NikoBrzezinski/stylophone/images/VolMin.jpg

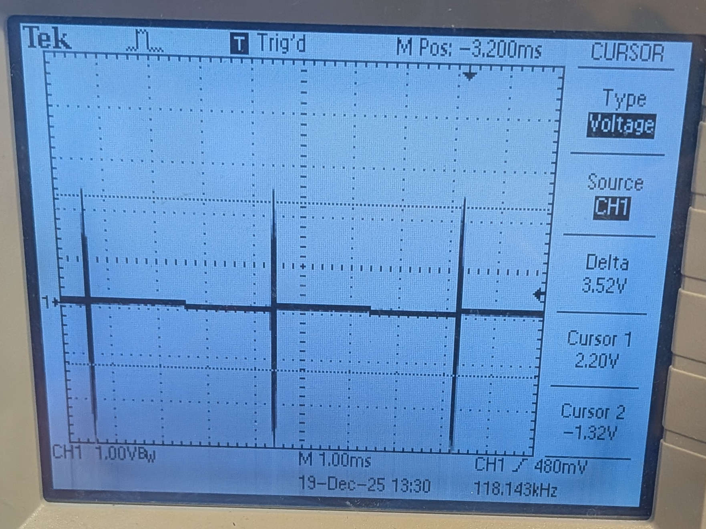
images/VolMin.jpg
