NikoBrzezinski/stylophone/images/PXL_20251219_131048569.jpg

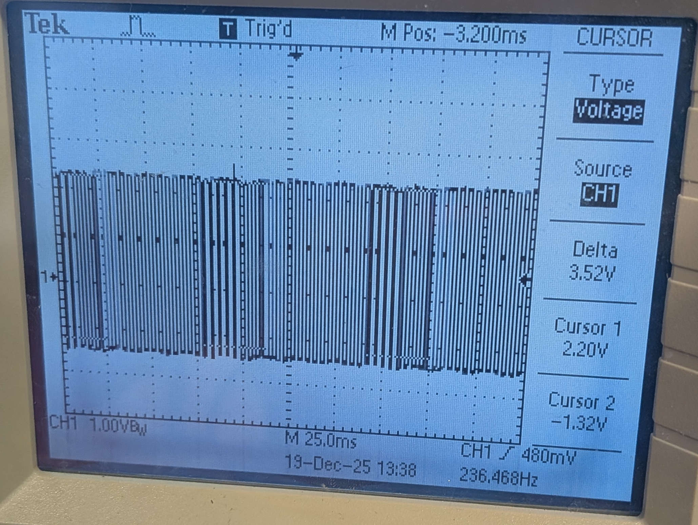
images/PXL_20251219_131048569.jpg
