NikoBrzezinski/stylophone/sprawko/main.tex

\documentclass{article}
\usepackage{graphicx} % Required for inserting images
\usepackage [utf8]{inputenc}
\usepackage {polski} 
\usepackage{float}

\title{Stylofon z efektem Vibrato}
\author{Brzeziński Radosław 277950}
\begin{document}
\maketitle
\tableofcontents
\section{Wstęp}
Projekt obejmuje zaprojektowanie, pomiary oraz wykonanie stylofonu z efektem vibrato, zbudowanego na bazie dwóch układów NE555. Częstotliwość dźwięku generowanego przez układ określana jest za pomocą stylusa. Im większa wartość rezystora, przez który układ zostaje w ten sposób zamknięty, tym niższa częstotliwość dźwięku.\newline
Pomysł na działanie układu zaczerpnięto z wcześniejszego zainteresowania projektowaniem syntezatorów oraz efektów dźwiękowych. \newline
Podstawowym źródłem wiedzy na temat budowy i działania układu były wcześniejsze wykłady oraz laboratoria, głównie zajęcia „Narzędzia CAD w projektowaniu układów elektronicznych”.

\section{Schemat układu i sposób działania}
\subsection{Działanie multiwibratora astabilnego}
\begin{figure}[H]
    \centering
    
    \caption{Licznik 555}
\end{figure}
\begin{figure}[H]
    \centering
    
    \caption{Multiwibrator astabilny}
\end{figure}
Działanie multiwibratora astabilnego składa się na dwie fazy.
\subsubsection{Faza ładowania kondensatora}
\begin{itemize}
    \item Po włączeniu zasilania kondensator C zaczyna się ładować przez $R_1+R_2$
    \item Napięcie na kondensatorze Vc rośnie wykładniczo
    \item Gdy Vc osiągnie poziom 2/3 Vcc, komparator 2 (TRESHOLD) ustawia przerzutnik RS a wyjście przechodzi w stan niski
    \item Tranzystor rozładowujący zostaje włączony i zaczyna rozładowywać kondensator przez $R_2$
\end{itemize}
\subsubsection{Faza rozładowania kondensatora}
\begin{itemize}
    \item Kondensator rozładowuje się przez $R_2$ do momentu, aż napięcie spadnie poniżej 1/3 Vcc.
    \item Komparator 1 (TRIGGER) resetuje przerzutnik RS a wyjście przechodzi w stan wysoki
    \item Tranzystor rozładowujący zostaje wyłączony i cykl rozpoczyna się od nowa
\end{itemize}
\subsection{Działanie stylofonu}
\begin{figure}[H]
    \centering
    
    \caption{Schemat ideowy stylofonu}
\end{figure}
\begin{figure}[H]
    \centering
    
    \caption{Schemat stylofonu}
\end{figure}
Stylofon składa się z dwóch układów NE555 pracujących w trybie multiwibratora astabilnego. Rezystor R2 układu generatora dźwięku został zastąpiony zestawem rezystorów oraz stylusem, który umożliwia wybór częstotliwości generowanego dźwięku. Wejście Control Voltage, kontrolujące napięcie graniczne, podłączone jest przez filtr dolnoprzepustowy do kolejnego układu NE555, również pracującego jako multiwibrator astabilny, co daje efekt vibrato. Filtr jest niezbędny do odfiltrowania wyższych harmonicznych z przebiegu prostokątnego generowanego przez układ. Wyjście generatora dźwięku podłączone jest do wzmacniacza operacyjnego w układzie voltage follower, co pozwala na podłączenie głośników o wyższej impedancji.\newline
\section{Symulacja oraz pomiary}
Analizie podano następujące parametry
\begin{itemize}
    \item Wyjście układu dźwięku oraz układu vibrato
    \item Przebieg wyjścia licznika 555 Tone
    \item Przebiegi ładowania i rozładowywania kondensatorów obu multiwibratorów
    \item Natężenie prądu pobieranego przez układ
    \item Wpływ potencjometru $R_{Volume}$
\end{itemize}
Analiza przeprowadzona jest dla napięcia Vcc = 5V, ponieważ układ przystosowany jest do zasilania przez port USB
\begin{figure}[H]
    \centering
    
    \caption{Przebiegi wyjść, dźwięku oraz vibrato}
\end{figure}
\begin{figure}[H]
    \centering
    
    \caption{Przebiegi ładowania i rozładowania kondensatorów}
\end{figure}
\begin{figure}[H]
    \centering
    
    \caption{Przebieg natężenia prądu źródła}
\end{figure}
\begin{figure}[H]
    \centering
    
    \caption{Schemat pomiarowy układu}
\end{figure}
\begin{figure}[H]
    \centering
    
    \caption{Wpływ potencjometry Volume}
\end{figure}
\section{Projekt płytki drukowanej}
\begin{figure}[H]
    \centering
    
    \caption{Projekt płytki PCB}
\end{figure}
\end{document}
