NikoBrzezinski/stylophone/images/Board.png

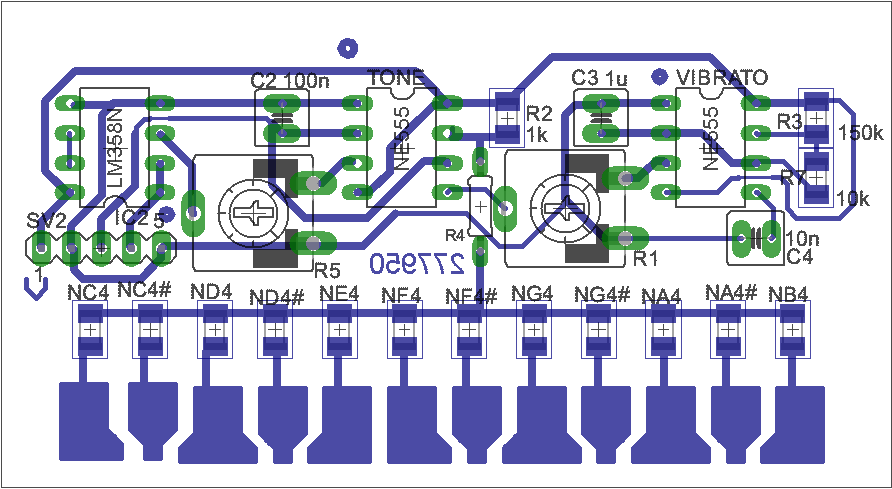
images/Board.png
