NikoBrzezinski/stylophone/images/C4.jpg

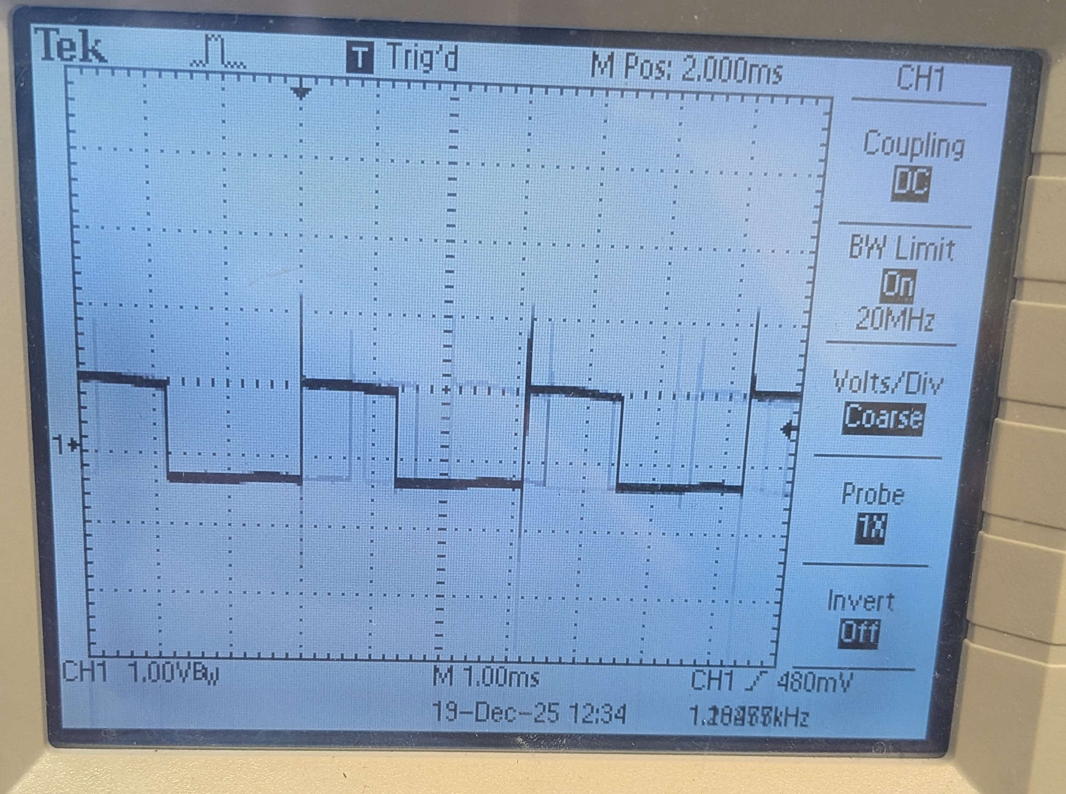
images/C4.jpg
