NikoBrzezinski/stylophone/images/CapTone.jpg

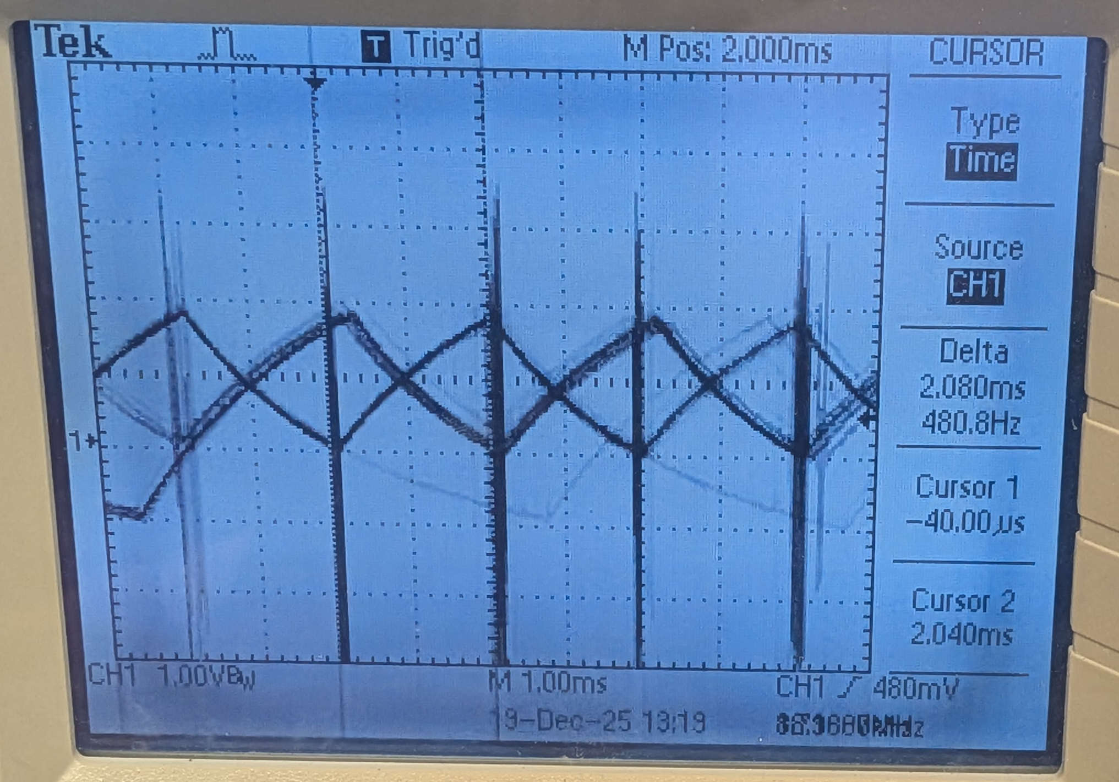
images/CapTone.jpg
