NikoBrzezinski/stylophone/images/CapVib.jpg

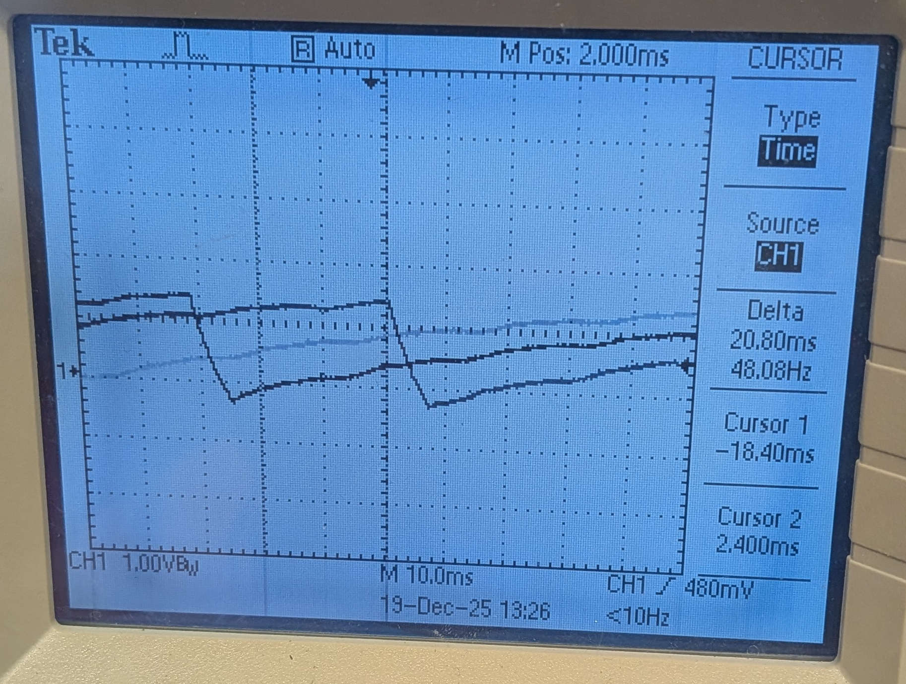
images/CapVib.jpg
