NikoBrzezinski/stylophone/images/OutTonePotMax.jpg

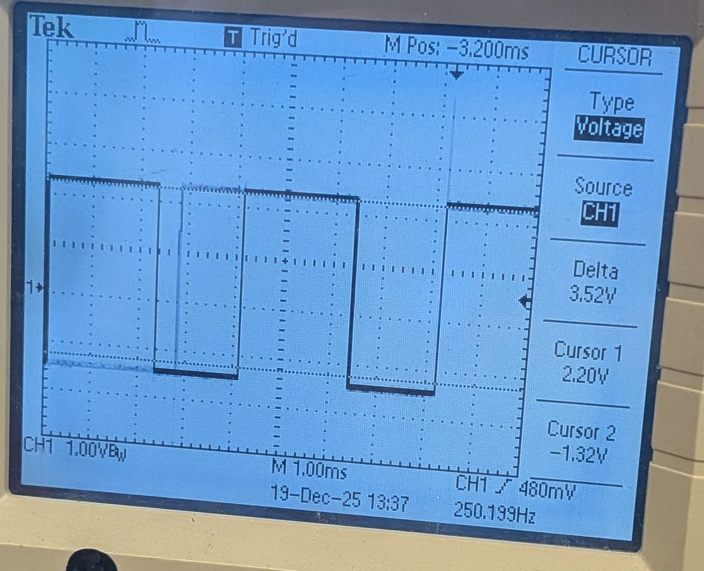
images/OutTonePotMax.jpg
