NikoBrzezinski/stylophone/images/OutTonePotMin.jpg

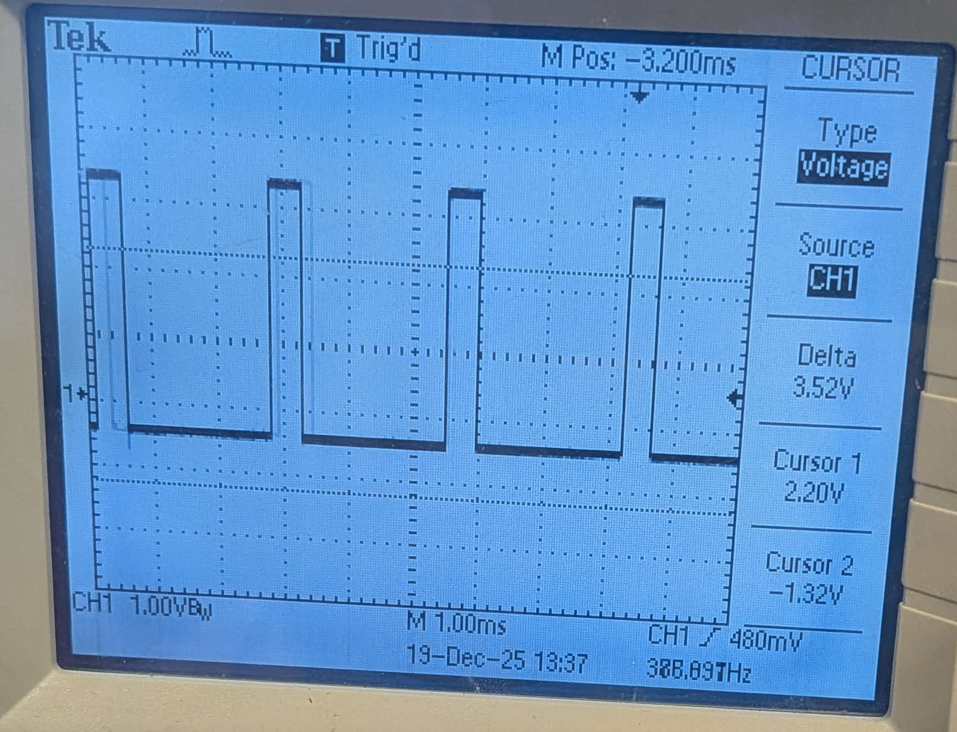
images/OutTonePotMin.jpg
