NikoBrzezinski/stylophone/images/OutVibPotMax.jpg

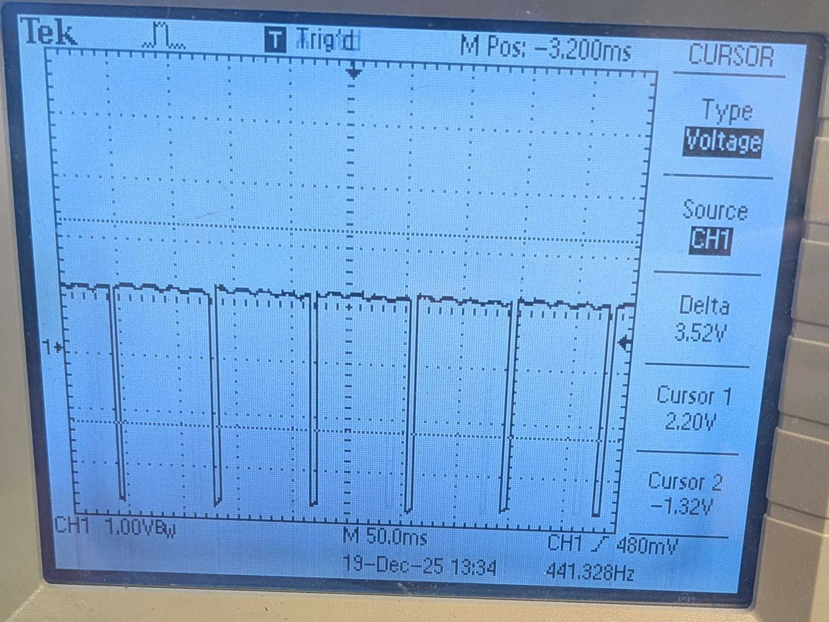
images/OutVibPotMax.jpg
