NikoBrzezinski/stylophone/images/OutVibPotMin.jpg

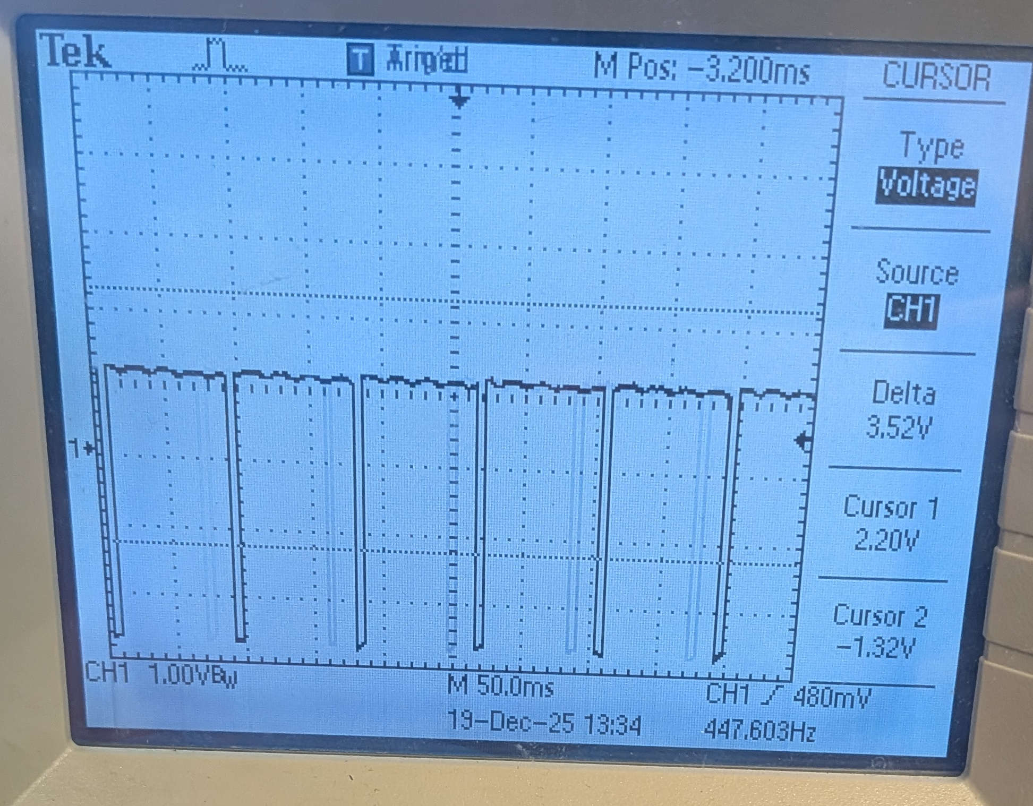
images/OutVibPotMin.jpg
