NikoBrzezinski/stylophone/images/PXL_20251219_131112526.jpg

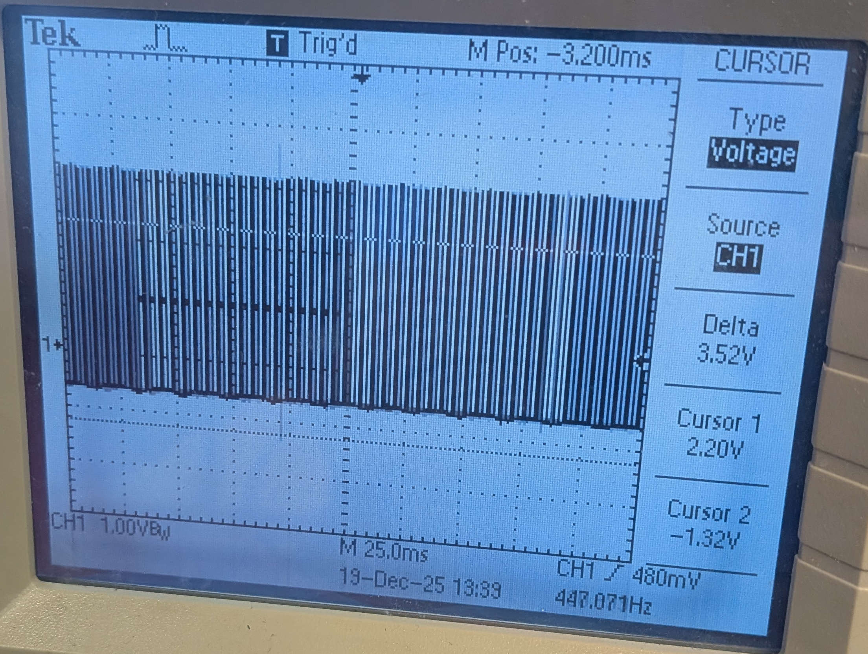
images/PXL_20251219_131112526.jpg
