NikoBrzezinski/stylophone/images/schematEagle.png

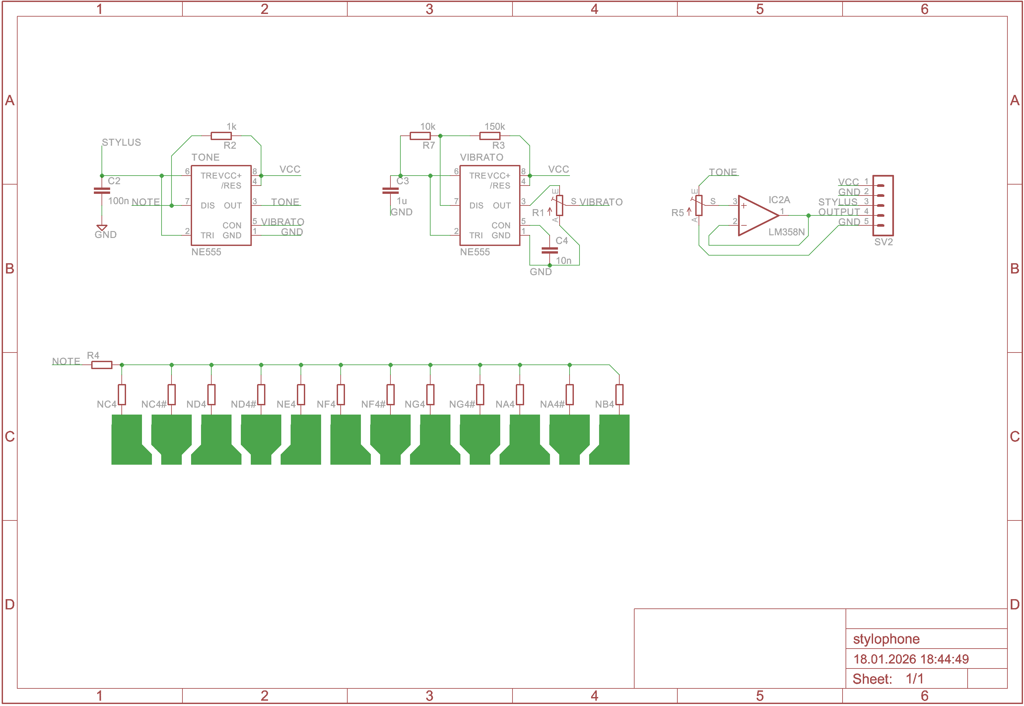
images/schematEagle.png
