NikoBrzezinski/stylophone/images/traces.png

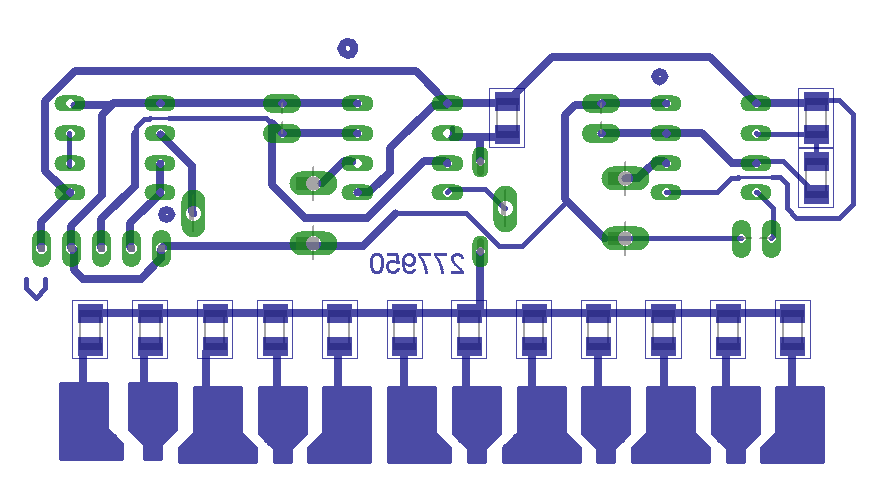
images/traces.png
