NikoBrzezinski/stylophone/images/VolMax.jpg

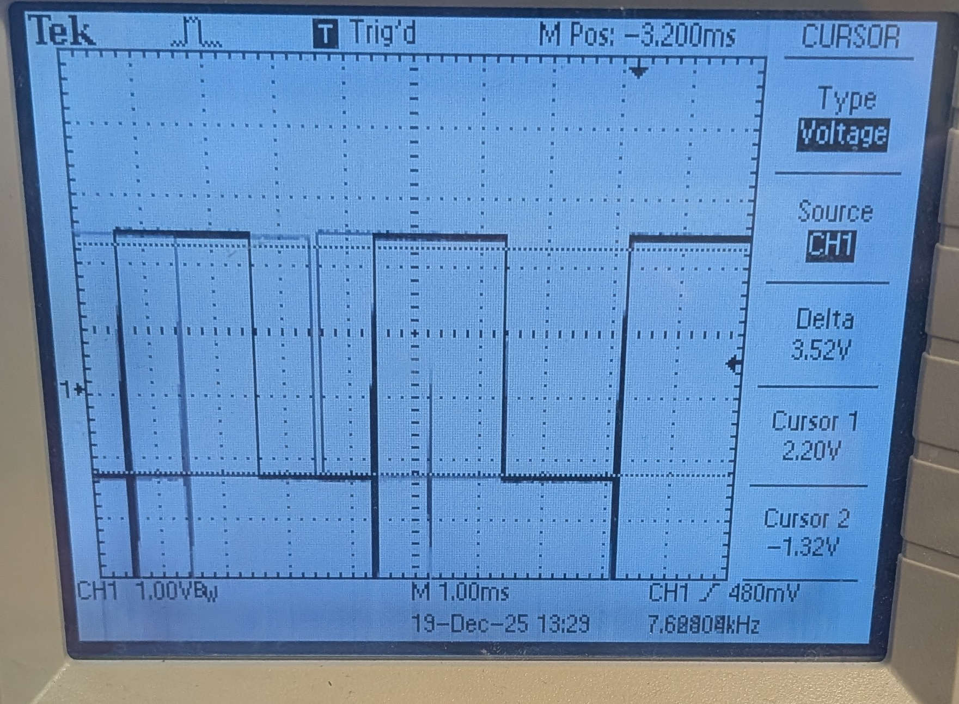
images/VolMax.jpg
