NikoBrzezinski/stylophone/sim/stylophonev01.asc

C2: cap; 100n
C3: cap; 10n
C4: cap; 1µ
NOTE: res; 27k
R1: res; 1k
R2: res; 18k
R3: res; 180k
R5: res; {Rb}
R6: res; 2k
R7: res; 8k
U1: NE555
U2: NE555
U3: UniversalOpAmp1
V1: voltage; 5
Volume: res; {Ra}
Named nets: 0, Vcc, stylus, Vibrato, Tone, CVibrato, Output
.tran 0.5
f=1,44/(r1+2r2)*C. C4=261Hz
vibrato
Main Tone Generator
Voltage follower. Required for high impedance load
.param Ra = R*(val/100)
.param Rb = R*(1-(val/100))
.param R = 10k
.step param val 10 100 25
