NikoBrzezinski/stylophone/PCB/stylophone.brd

## EAGLE design PCB/stylophone.brd (2026-03-12)

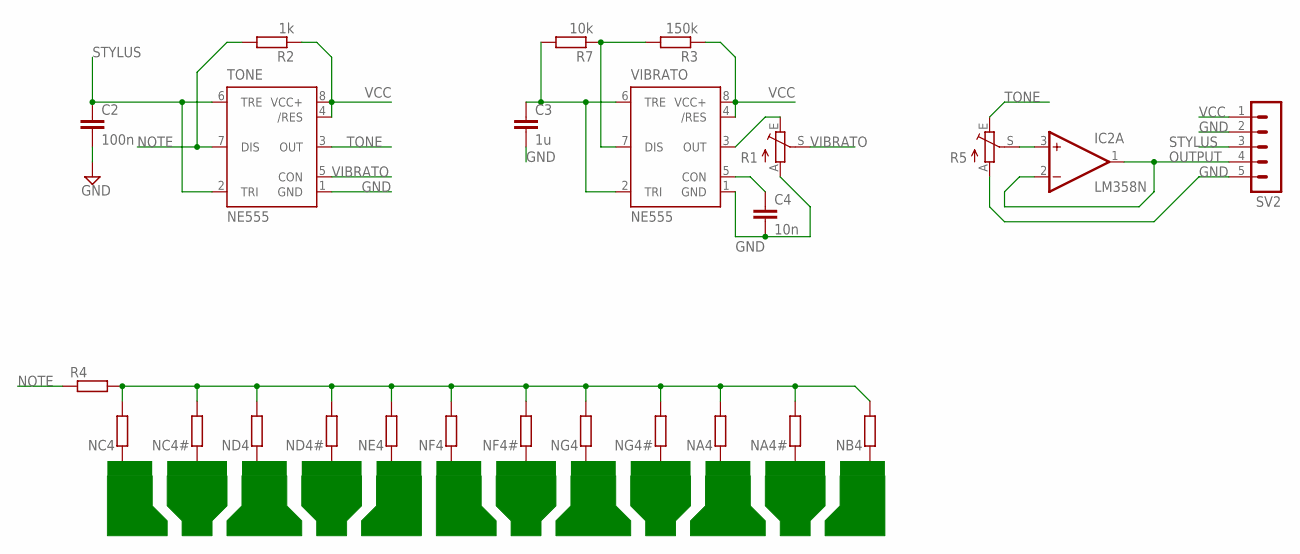
[picture p15: schematic stylophone.sch]

Parts:
C2: 100n; C2.5-5
C3: 1u; C2.5-5
C4: 10n; C2.5-5
IC2: LM358N; DIL08
NA4, NA4#: R-EU_M1206; M1206
NB4: R-EU_M1206; M1206
NC4, NC4#: R-EU_M1206; M1206
ND4, ND4#: R-EU_M1206; M1206
NE4: R-EU_M1206; M1206
NF4, NF4#: R-EU_M1206; M1206
NG4, NG4#: R-EU_M1206; M1206
R1, R5: TRIM_EU-CA9V; CA9V
R2: 1k; M1206
R3: 150k; M1206
R4: R-EU_0204/7; 0204/7
R7: 10k; M1206
SV2: MA05-1
TONE: NE555; DIL-08
VIBRATO: NE555; DIL-08

Connections:
GND: C2.2, C3.2, C4.2, IC2.4 (V-), R1.A, R5.A, SV2.2, SV2.5, TONE.1 (GND), VIBRATO.1 (GND)
KEYBOARD: NA4.2, NA4#.2, NB4.2, NC4.2, NC4#.2, ND4.2, ND4#.2, NE4.2, NF4.2, NF4#.2, NG4.2, NG4#.2, R4.2
unnamed: C4.1, VIBRATO.5 (CON)
unnamed: R1.E, VIBRATO.3 (OUT)
unnamed: R3.2, R7.1, VIBRATO.7 (DIS)
unnamed: IC2.3 (+IN), R5.S
NOTE: R2.2, R4.1, TONE.7 (DIS)
NOTSTYLUS: C3.1, R7.2, VIBRATO.2 (TRI), VIBRATO.6 (TRE)
OUTPUT: IC2.1 (OUT), IC2.2 (-IN), SV2.4
STYLUS: C2.1, SV2.3, TONE.2 (TRI), TONE.6 (TRE)
TONE: R5.E, TONE.3 (OUT)
V+: IC2.8 (V+)
V-: IC2.4 (V-)
VCC: IC2.8 (V+), R2.1, R3.1, SV2.1, TONE.4 (/RES), TONE.8 (VCC+), VIBRATO.4 (/RES), VIBRATO.8 (VCC+)
VIBRATO: R1.S, TONE.5 (CON)

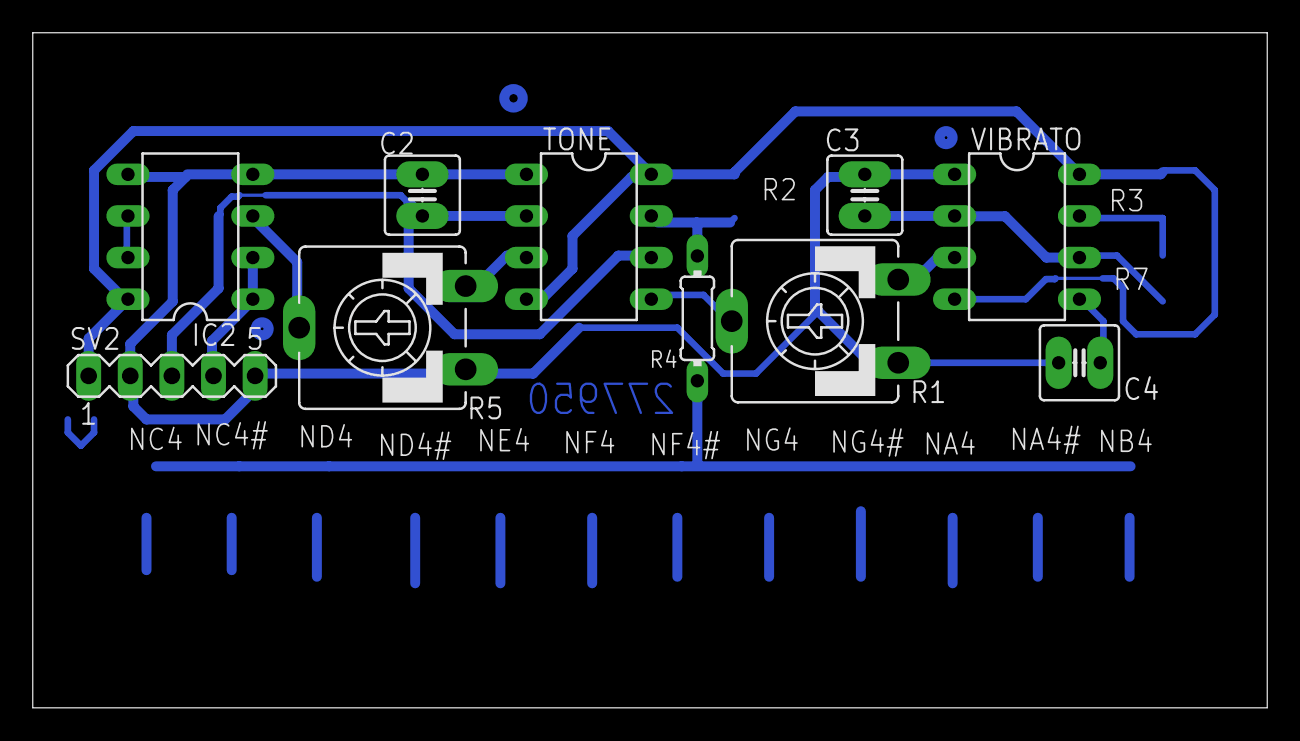
[picture p16: board stylophone.brd from above]

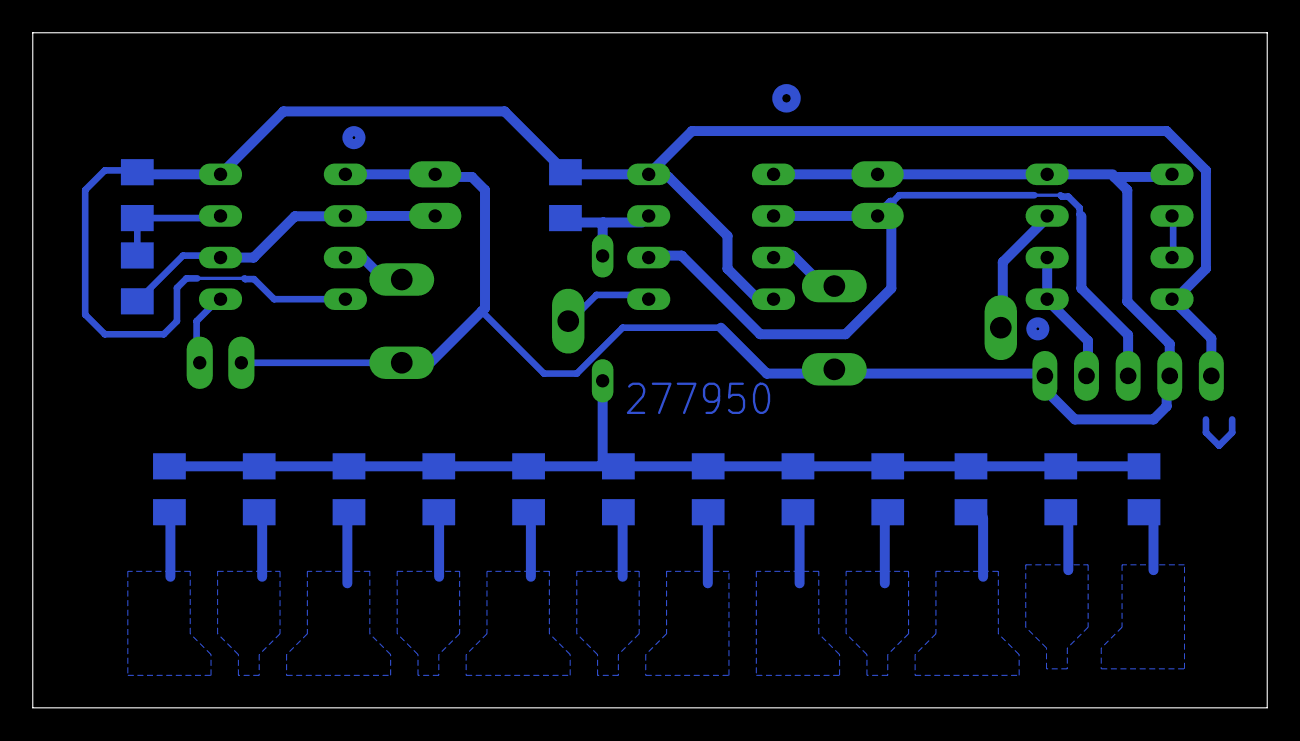
[picture p17: board stylophone.brd from below]

Board: 2 copper layers, 75.3 x 41.2 mm, 25 parts (15 on the bottom side), 13 nets.
